Arcturus314/SSRController/ssrcontroller_basic/18 - MouserBom.xls

Mfr Part Number (Input) | Quantity 1 | Mfr Part Number | Mouser Part Number | Manufacturer Name | Description | Unit Price 1 | Order Quantity | Order Unit Price | Min./Mult. | Availability | Lead Time in Days | Lead Time in Weeks | Lifecycle | NCNR | RoHS | Pb Free | Package Type | Package Quantity | Datasheet URL | Product Image | Design Risk
713-102010268 | 1 | 102010268 | 713-102010268 | Seeed Studio | Development Boards & Kits - AVR Development Boards & Kits - AVR Seeeduino Nano | $8.62 | 1 | $8.62 | 1\1 | 114 | 97 | 14 | New Product | No | No | No |  | 1 |  |  | Product is new and is readily available.
80-ESK476M016AC3KA | 1 | ESK476M016AC3KA | 80-ESK476M016AC3KA | KEMET | Aluminum Electrolytic Capacitors - Radial Leaded Aluminum Electrolytic Capacitors - Radial Leaded 16V 47uF 85C 2k Hour Radial | $0.17 | 1 | $0.17 | 1\1 | 6,514 | 164 | 24 |  | No | Yes | Yes | REEL | 2,600 | https://www.mouser.com/datasheet/2/212/KEM_A4004_ESK-1103206.pdf |  | Product has high popularity and is readily available.
926-LM7805CT | 1 | LM7805CT/NOPB (https://www.mouser.com/ProductDetail/Texas-Instruments/LM7805CT-NOPB?qs=OYMYEaN9QmBS2GvaX6GSkQ%3D%3D) | 926-LM7805CT/NOPB | Texas Instruments | Linear Voltage Regulators 5 Volt Reg | $1.62 | 1 | $1.62
710-860010772003 | 1 | 860010772003 | 710-860010772003 | Wurth Elektronik | Aluminum Electrolytic Capacitors - Radial Leaded Aluminum Electrolytic Capacitors - Radial Leaded WCAP-ATG8 0.33uF 63V 20% Radial | $0.11 | 1 | $0.11 | 1\1 | 2,429 |  |  |  | No | Yes | Yes | AMMO PACK | 2,000 | https://www.mouser.com/datasheet/2/445/860010772003-1725323.pdf |  | Product has high popularity and is readily available.
710-860010772001 | 1 | 860010772001 | 710-860010772001 | Wurth Elektronik | Aluminum Electrolytic Capacitors - Radial Leaded Aluminum Electrolytic Capacitors - Radial Leaded WCAP-ATG8 0.1uF 63V 20% Radial | $0.10 | 1 | $0.10 | 1\1 | 1,272 | 155 | 23 |  | No | Yes | Yes | AMMO PACK | 2,000 | https://www.mouser.com/datasheet/2/445/860010772001-1725267.pdf |  | Product has high popularity and is readily available.
490-TB006-508-02BE | 5 | TB006-508-02BE | 490-TB006-508-02BE | CUI Devices | Fixed Terminal Blocks Fixed Terminal Blocks Terminal block, screw type, 5.08 , horizontal, 2 poles, CUI Blue, slotted screw, PCB mount | $0.55 | 5 | $0.55 | 1\1 | 5,122 | 65 | 10 | New at Mouser | No | Yes | Yes |  | 500 | https://www.mouser.com/datasheet/2/670/tb006_508-1550645.pdf |  | Product is new and is readily available.
163-4302-E | 1 | 163-4302-E | 163-4302-E | Kobiconn | DC Power Connectors DC Power Connectors PANEL MOUNT 2.1MM | $1.51 | 1 | $1.51 | 1\1 | 22,614 | 125 | 18 |  | No | Yes | Yes | BULK | 100 | https://www.mouser.com/datasheet/2/253/KC-301339-1177650.pdf |  | Product has high popularity and is readily available.
660-MFS1/4DCT52A1002 | 10 | MFS1/4DCT52A1002F | 660-MFS1/4DCT52A1002 | KOA Speer | Metal Film Resistors - Through Hole Metal Film Resistors - Through Hole 10K ohm 1% | $0.10 | 10 | $0.10 | 1\1 | 3,317 | 98 | 14 |  | No | Yes | Yes | AMMO PACK | 3,000 | https://www.mouser.com/datasheet/2/219/MF_MFS_RK-18760.pdf |  | Product has high popularity and is readily available.
858-P160KNP-3FD20B5K | 3 | P160KNP-3FD20B5K | 858-P160KNP-3FD20B5K | TT Electronics | Potentiometers Potentiometers 16mm 5K ohm 20% Rotary Potentiometer | $0.86 | 3 | $0.86 | 1\1 | 2,089 | 133 | 19 |  | No | Yes | No | TRAY | 1,100 | https://www.mouser.com/datasheet/2/414/P160-1545428.pdf |  | Product has high popularity and is readily available.
485-3429 | 3 | 3429 | 485-3429 | Adafruit | Adafruit Accessories Adafruit Accessories Mini LED Arcade Button - 24mm Translucent Clear | $2.50 | 3 | $2.50 | 1\1 | 30 | 114 | 17 |  | No | Yes | No |  | 1 |  |  | Product has high popularity and is readily available.
MF1/4LCT52R102G | 5 | MF1/4LCT52R102G | 660-MF1/4LCT52R102G | KOA Speer | Metal Film Resistors - Through Hole Metal Film Resistors - Through Hole 1/4 WATT 1K OHM 2% | $0.10 | 5 | $0.10 | 1\1 | 8,861 | 102 | 15 |  | No | Yes | Yes | REEL | 5,000 | https://www.mouser.com/datasheet/2/219/MF_MFS_RK-18760.pdf |  | Product has high popularity and is readily available.
612-PS1023ABLK | 2 | PS1023ABLK | 612-PS1023ABLK | E-Switch | Pushbutton Switches Pushbutton Switches 3A 125VAC Off-(On) Black | $1.51 | 2 | $1.51 | 1\1 | 724 | 112 | 16 |  | No | Yes | No |  | 1 | https://www.mouser.com/datasheet/2/140/E_Switch_PS1023-1165681.pdf |  | Product has high popularity and is readily available.
926-LM7805CT/NOPB | 1 | LM7805CT/NOPB | 926-LM7805CT/NOPB | Texas Instruments | Linear Voltage Regulators Linear Voltage Regulators 5 Volt Reg | $1.62 | 1 | $1.62 | 1\1 | 15,287 | 42 | 6 |  | No | Yes | No | TUBE | 45 | http://www.ti.com/general/docs/suppproductinfo.tsp?distId=26 |  | Product has high popularity and is readily available.
2N3904 PBFREE | 3 | 2N3904 PBFREE | 610-2N3904 | Central Semiconductor | Bipolar Transistors - BJT Bipolar Transistors - BJT NPN Gen Pur SS | $0.45 | 3 | $0.45 | 1\1 | 33,415 | 168 | 24 |  | No | Yes | Yes | BULK | 2,500 | https://my.centralsemi.com/datasheets/2N3903.PDF |  | Product has high popularity and is readily available.
R30-3011802 | 4 | R30-3011802 | 855-R30-3011802 | Harwin | Standoffs & Spacers M3 x 18mm HEX 5mmA/F 8mm ML/FML NICKEL | 0.64
