Arcturus314/SSRController/ssrcontroller/ssrcontroller_mcu/BOM.ods

Per-Board
Part | # | Price (single) | Price (total) | URL
Arduino Nano | 1 | 4 | 4 | https://www.amazon.com/ATmega328P-Controller-Module-CH340G-Arduino/dp/B07RQ8S1LG
47uF 12V cap | 1 | 0.06 | 0.06 | https://www.mouser.com/ProductDetail/Lelon/REA470M1CBK-0511P?qs=LVGG2qFPDbGuSPcHtpe6Lw%3D%3D
LM7805 (TO220) | 1 | 1.81 | 1.81 | https://www.mouser.com/ProductDetail/Texas-Instruments/LM7805CT?qs=QbsRYf82W3EaqXeMDVwIfQ%3D%3D
.33uF cap | 1 | 0.11 | 0.11 | https://www.mouser.com/ProductDetail/Wurth-Elektronik/860010772003
.1uF cap | 1 | 0.1 | 0.1 | https://www.mouser.com/ProductDetail/Wurth-Elektronik/860010772001
Power adapter | 1 | 7.99 | 7.99 | https://www.amazon.com/TMEZON-Power-Adapter-Supply-2-1mm/dp/B00Q2E5IXW?s=electronics
2.1x5.5 barrel jack | 1 | 1 | 1 | https://www.mouser.com/ProductDetail/Gravitech/CON-SOCJ-2155?qs=fkzBJ5HM%252BdCcpvFQyQZHtA%3D%3D
Pushbutton | 2 | 0.4 | 0.8 | https://www.mouser.com/ProductDetail/E-Switch/TL1105JAF250Q?qs=HKd%2Fp3M7KlXMyKdRvA%2FYOw%3D%3D
PCB | 1 | 0.7 | 0.7 | assuming quantity 15
Total |  |  | 16.57
Total for 555 implementation |  |  | 12
Per-Channel
Part | # | Price (single) | Price (total) | URL
Alps RK09K | 1 | 0.56 | 0.56 | https://www.mouser.com/ProductDetail/Alps-Alpine/RK09K1110-K25-C1-B103?qs=lhR5sLRcJHCQBwwGWQ%2F%252B5A%3D%3D
10K resistor | 2 | 0.005 | 0.01
3 pin header (2.54mm) | 1 | 0.1 | 0.1
5.08mm screw terminal | 1 | 0.55 | 0.55 | https://www.mouser.com/ProductDetail/CUI-Devices/TB006-508-02BE?qs=vLWxofP3U2wEdOVV%2FaT04w%3D%3D
2N3904 (TO92) | 1 | 0.45 | 0.45 | https://www.mouser.com/ProductDetail/Central-Semiconductor/2N3904-PBFREE?qs=u16ybLDytRZopNVvg2vJjA%3D%3D
Pushbutton | 1 | 0.4 | 0.4 | https://www.mouser.com/ProductDetail/E-Switch/TL1105JAF250Q?qs=HKd%2Fp3M7KlXMyKdRvA%2FYOw%3D%3D
SSR | 1 | 12 | 12
Total |  |  | 14.07
Total for 555 implementation |  |  | 16
Arduino |  | total | per channel
So for 12 channels, 1 channel per board |  | 367.68 | 30.64
So for 12 channels, 3 channels per board |  | 235.12 | 19.5933333333333
555 |  | total | per channel
So for 12 channels, 1 channel per board |  | 336 | 28
So for 12 channels, 3 channels per board |  | 240 | 20
New Stuff
Resistors for thermistor channels
Enclosure | https://www.amazon.com/Zulkit-Electronic-Enclosures-Enclosure-Preventive/dp/B08BS39P69
C14 panel mount connectors
barrel jack connector for panel power
Panel mount buttons and pots
Potentiometer knobs
Protection diodes for arduino vin
Can power Arduino with 12V anyway
