Arcturus314/SSRController/ssrcontroller/ssrcontroller_mcu/BOM_inbox.xlsx

Per-Board
Part | # | Price (single) | Price (total) | URL
Arduino Nano | 1 | 4 | 4 | https://www.amazon.com/ATmega328P-Controller-Module-CH340G-Arduino/dp/B07RQ8S1LG
47uF 12V cap | 1 | 0.06 | 0.06 | https://www.mouser.com/ProductDetail/Lelon/REA470M1CBK-0511P?qs=LVGG2qFPDbGuSPcHtpe6Lw%3D%3D
LM7805 (TO220) | 1 | 1.81 | 1.81 | https://www.mouser.com/ProductDetail/Texas-Instruments/LM7805CT?qs=QbsRYf82W3EaqXeMDVwIfQ%3D%3D
.33uF cap | 1 | 0.11 | 0.11 | https://www.mouser.com/ProductDetail/Wurth-Elektronik/860010772003
.1uF cap | 1 | 0.1 | 0.1 | https://www.mouser.com/ProductDetail/Wurth-Elektronik/860010772001
12V Power adapter | 1 | 7.99 | 7.99 | https://www.amazon.com/TMEZON-Power-Adapter-Supply-2-1mm/dp/B00Q2E5IXW?s=electronics
5.08mm screw terminal | 1 | 0.55 | 0.55 | https://www.mouser.com/ProductDetail/CUI-Devices/TB006-508-02BE?qs=vLWxofP3U2wEdOVV%2FaT04w%3D%3D
PCB | 1 | 0.7 | 0.7 | assuming quantity 15
Panel mount pushbutton | 2 | 1.51 | 1.7 | https://www.mouser.com/ProductDetail/E-Switch/PS1023ABLK?qs=QtyuwXswaQiGuKxM8UD2UA%3D%3D
Panel mount barrel jack | 1 | 1.51 | 2.7 | https://www.mouser.com/ProductDetail/Kobiconn/163-4302-E
Enclosure | 1 | 20.99 | 20.99 | https://www.amazon.com/Zulkit-Electronic-Enclosures-Enclosure-Preventive/dp/B08BS39P69
Total |  |  | 40.71
Per-Channel
Part | # | Price (single) | Price (total) | URL
10K resistor | 2 | 0.005 | 0.01
3 pin header (2.54mm) | 1 | 0.1 | 0.1
5.08mm screw terminal | 1 | 0.55 | 0.55 | https://www.mouser.com/ProductDetail/CUI-Devices/TB006-508-02BE?qs=vLWxofP3U2wEdOVV%2FaT04w%3D%3D
2N3904 (TO92) | 1 | 0.45 | 0.45 | https://www.mouser.com/ProductDetail/Central-Semiconductor/2N3904-PBFREE?qs=u16ybLDytRZopNVvg2vJjA%3D%3D
SSR | 1 | 12 | 12
Panel mount potentiometer | 1 | 0.86 | 0.86 | https://www.mouser.com/ProductDetail/BI-Technologies-TT-Electronics/P160KNP-3FD20B5K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
Panel mount pushbutton w/ LED | 1 | 2.5 | 2.5 | https://www.mouser.com/ProductDetail/Adafruit/3429/?qs=5aG0NVq1C4wproJuXLeckg%3D%3D
6mm knob | 1 | 4.33 | 4.33 | https://www.amazon.com/mxuteuk-Aluminum-Potentiometer-Electric-KNOB-06-25SR/dp/B07TSR4N4Q
Panel mount C14 connector | 1 | 0.699 | 0.699 | https://www.amazon.com/Panel-Adapter-Connector-Socket-MXR/dp/B07DCXKNXQ
Panel mount type A socket | 1 | 3.495 | 3.495 | https://www.amazon.com/AXLIZER-Outlet-Socket-Connector-Supply/dp/B08PTXCK5Q
Total |  |  | 24.994
Arduino |  | total | per channel
So for 12 channels, 1 channel per board |  | 788.448 | 65.704
So for 12 channels, 3 channels per board |  | 462.768 | 38.564
