Arcturus314/SSRController/ssrcontroller_basic/BoM_amazon_withoutspares.ods

Name | Quantity | Price | Extended Price | URL
Enclosure | 1 | 21.99 | 21.99 | https://www.amazon.com/Zulkit-Electronic-Enclosures-Enclosure-Preventive/dp/B08BS39P69
SSR | 3 | 12.29 | 36.87 | https://www.amazon.com/INKBIRD-Solid-State-SSR-40DA-24-380V/dp/B00HV974KC
Wall connectors | 2 | 6.99 | 13.98 | https://www.amazon.com/AXLIZER-Outlet-Socket-Connector-Supply/dp/B08PTXCK5Q
