Arcturus314/SSRController/ssrcontroller_basic/BoM_amazon.ods

Name | Quantity | Price | Extended Price | URL
12V Power Adapter | 1 | 13.88 | 13.88 | https://www.amazon.com/12V-Power-Supply-Driver-Transformer/dp/B08YDCL87G
Enclosure | 1 | 21.99 | 21.99 | https://www.amazon.com/Zulkit-Electronic-Enclosures-Enclosure-Preventive/dp/B08BS39P69
SSR | 2 | 12.29 | 24.58 | https://www.amazon.com/INKBIRD-Solid-State-SSR-40DA-24-380V/dp/B00HV974KC
Potentiometer Knobs | 1 | 9.99 | 9.99 | https://www.amazon.com/mxuteuk-Potentiometer-Control-Electric-KNOB-A03/dp/B07TTVPWTH
C14 connectors | 1 | 6.99 | 6.99 | https://www.amazon.com/Panel-Adapter-Connector-Socket-MXR/dp/B07DCXKNXQ
Wall connectors | 2 | 6.99 | 13.98 | https://www.amazon.com/AXLIZER-Outlet-Socket-Connector-Supply/dp/B08PTXCK5Q
