Arcturus314/SSRController/ssrcontroller/ssrcontroller_mcu/ssrcontroller_mcu.kicad_pcb

## KiCad design ssrcontroller/ssrcontroller_mcu/ssrcontroller_mcu.kicad_pcb (2021-08-17)

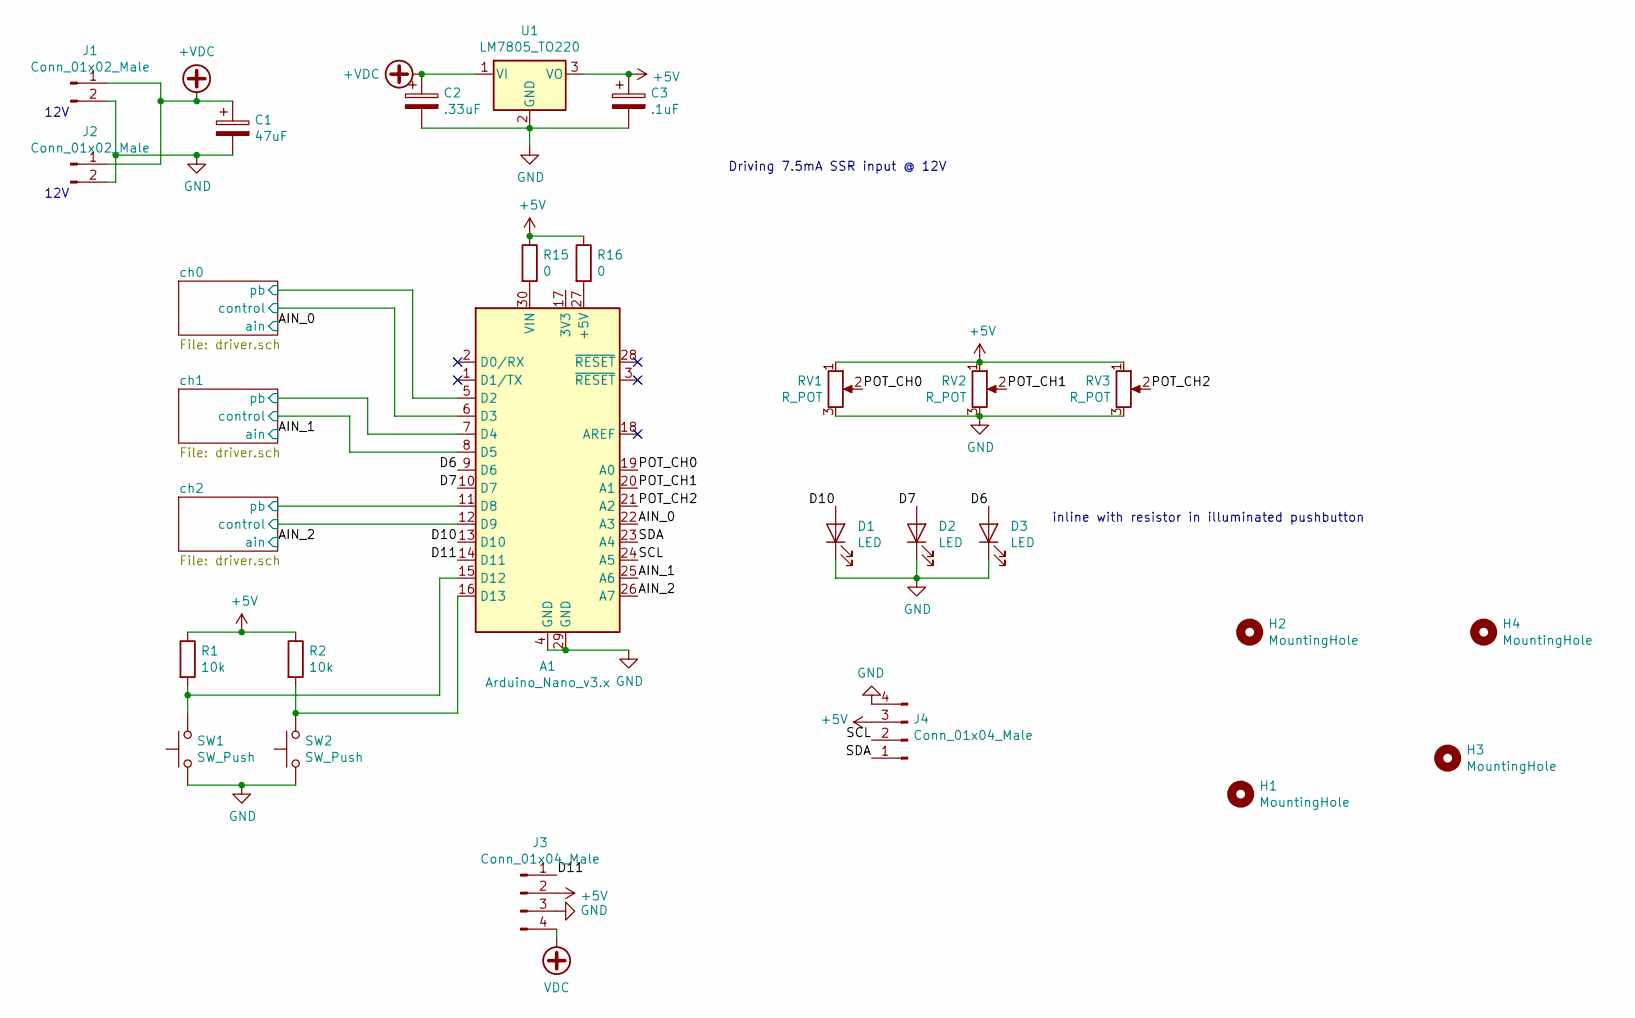
[picture p1: schematic ssrcontroller_mcu.sch]

Parts:
A1: Arduino_Nano_v3.x; Arduino_Nano
C1: 47uF; CP_Radial_D5.0mm_P2.00mm
C2: .33uF; CP_Radial_D5.0mm_P2.00mm
C3: .1uF; CP_Radial_D5.0mm_P2.00mm
D1, D2, D3: LED; PinHeader_1x02_P2.54mm_Vertical
H1, H2, H3, H4: MountingHole; MountingHole_3.2mm_M3_DIN965_Pad
J1: Conn_01x02_Male; BarrelJack_Horizontal
J2: Conn_01x02_Male; TerminalBlock_Phoenix_MKDS-1,5-2_1x02_P5.00mm_Horizontal
J3: Conn_01x04_Male; PinHeader_1x04_P2.54mm_Vertical
J4: Conn_01x04_Male; PinSocket_1x04_P2.54mm_Vertical
R1, R2: 10k; R_Axial_DIN0207_L6.3mm_D2.5mm_P7.62mm_Horizontal
R15, R16: 0; R_0603_1608Metric_Pad1.05x0.95mm_HandSolder
RV1, RV2, RV3: R_POT; Potentiometer_Alps_RK09K_Single_Horizontal
SW1, SW2: SW_Push; SW_Tactile_SKHH_Angled
U1: LM7805_TO220; TO-220-3_Horizontal_TabDown

Connections:
+5V: C3.1, J3.2, J4.3, R1.1, R2.1, R15.1, R16.1, RV1.1, RV2.1, RV3.1, U1.3 (VO); also elsewhere on the board
+VDC: C1.1, C2.1, J1.1, J2.1, U1.1 (VI); also elsewhere on the board
/AIN_0: A1.22 (A3); also elsewhere on the board
/AIN_1: A1.25 (A6); also elsewhere on the board
/AIN_2: A1.26 (A7); also elsewhere on the board
/D6: A1.9 (D6), D3.2 (A)
/D7: A1.10 (D7), D2.2 (A)
/D10: A1.13 (D10), D1.2 (A)
/D11: A1.14 (D11), J3.1
/POT_CH0: A1.19 (A0), RV1.2
/POT_CH1: A1.20 (A1), RV2.2
/POT_CH2: A1.21 (A2), RV3.2
/SCL: A1.24 (A5), J4.2
/SDA: A1.23 (A4), J4.1
/ch0/control: A1.6 (D3); also elsewhere on the board
/ch0/pb: A1.5 (D2); also elsewhere on the board
/ch1/control: A1.8 (D5); also elsewhere on the board
/ch1/pb: A1.7 (D4); also elsewhere on the board
/ch2/control: A1.12 (D9); also elsewhere on the board
/ch2/pb: A1.11 (D8); also elsewhere on the board
GND: A1.4 (GND), A1.29 (GND), C1.2, C2.2, C3.2, D1.1 (K), D2.1 (K), D3.1 (K), J1.2, J2.2, J3.3, J4.4, RV1.3, RV2.3, RV3.3, SW1.1, SW2.1, U1.2 (GND); also elsewhere on the board
unnamed: A1.15 (D12), R1.2, SW1.2
unnamed: A1.16 (D13), R2.2, SW2.2
unnamed: A1.27 (+5V), R16.2
unnamed: A1.30 (VIN), R15.2
VDC: J3.4

Notes on the sheet:
Driving 7.5mA SSR input @ 12V
12V
inline with resistor in illuminated pushbutton

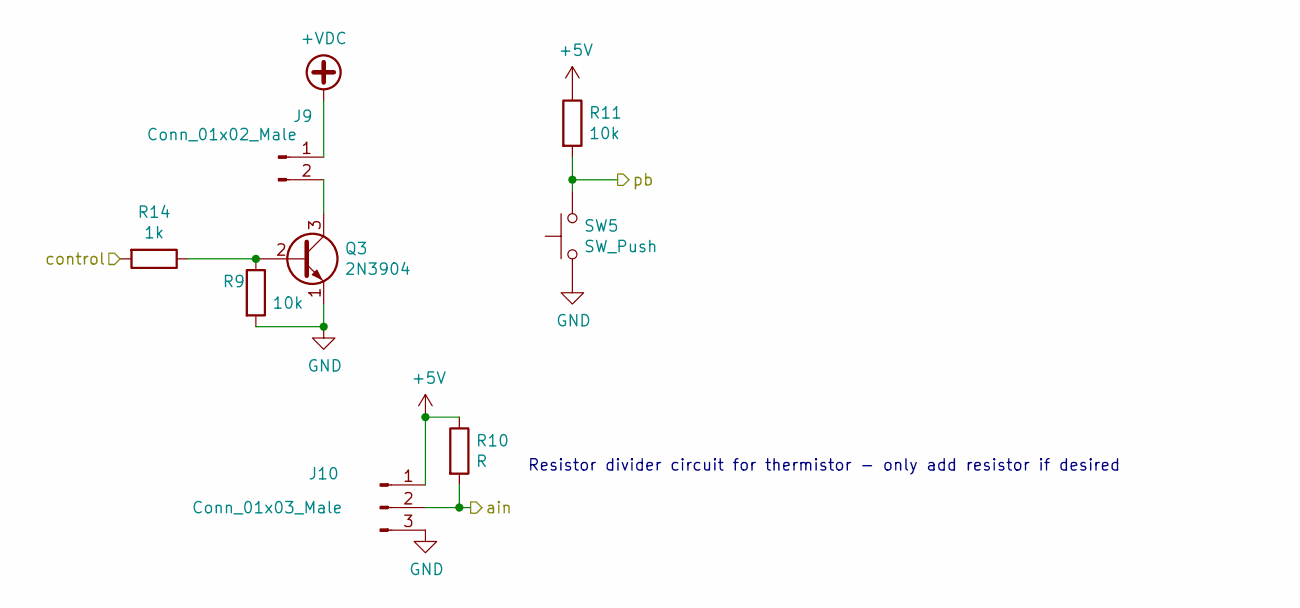
[picture p2: schematic driver.sch]

Parts:
J5: Conn_01x02_Male; TerminalBlock_Phoenix_MKDS-1,5-2_1x02_P5.00mm_Horizontal
J6: Conn_01x03_Male; PinHeader_1x03_P2.54mm_Vertical
Q1: 2N3904; TO-92_Inline
R3, R5: 10k; R_Axial_DIN0207_L6.3mm_D2.5mm_P7.62mm_Horizontal
R4: R; R_Axial_DIN0207_L6.3mm_D2.5mm_P7.62mm_Horizontal
R12: 1k; R_Axial_DIN0207_L6.3mm_D2.5mm_P7.62mm_Horizontal
SW3: SW_Push; SW_Tactile_SKHH_Angled

Connections:
+5V: J6.1, R4.1, R5.1; also elsewhere on the board
+VDC: J5.1; also elsewhere on the board
/AIN_0: J6.2, R4.2; also elsewhere on the board
/ch0/control: R12.2; also elsewhere on the board
/ch0/pb: R5.2, SW3.2; also elsewhere on the board
GND: J6.3, Q1.1 (E), R3.2, SW3.1; also elsewhere on the board
unnamed: J5.2, Q1.3 (C)
unnamed: Q1.2 (B), R3.1, R12.1

Parts of its further copies:
J7, J9: Conn_01x02_Male; TerminalBlock_Phoenix_MKDS-1,5-2_1x02_P5.00mm_Horizontal
J8, J10: Conn_01x03_Male; PinHeader_1x03_P2.54mm_Vertical
Q2, Q3: 2N3904; TO-92_Inline
R6, R8, R9, R11: 10k; R_Axial_DIN0207_L6.3mm_D2.5mm_P7.62mm_Horizontal
R7, R10: R; R_Axial_DIN0207_L6.3mm_D2.5mm_P7.62mm_Horizontal
R13, R14: 1k; R_Axial_DIN0207_L6.3mm_D2.5mm_P7.62mm_Horizontal
SW4, SW5: SW_Push; SW_Tactile_SKHH_Angled

Connections of its further copies:
+5V: J8.1, J10.1, R7.1, R8.1, R10.1, R11.1; also elsewhere on the board
+VDC: J7.1, J9.1; also elsewhere on the board
/AIN_1: J8.2, R7.2; also elsewhere on the board
/AIN_2: J10.2, R10.2; also elsewhere on the board
/ch1/control: R13.2; also elsewhere on the board
/ch1/pb: R8.2, SW4.2; also elsewhere on the board
/ch2/control: R14.2; also elsewhere on the board
/ch2/pb: R11.2, SW5.2; also elsewhere on the board
GND: J8.3, J10.3, Q2.1 (E), Q3.1 (E), R6.2, R9.2, SW4.1, SW5.1; also elsewhere on the board
unnamed: J7.2, Q2.3 (C)
unnamed: J9.2, Q3.3 (C)
unnamed: Q2.2 (B), R6.1, R13.1
unnamed: Q3.2 (B), R9.1, R14.1

Notes on the sheet:
Resistor divider circuit for thermistor - only add resistor if desired

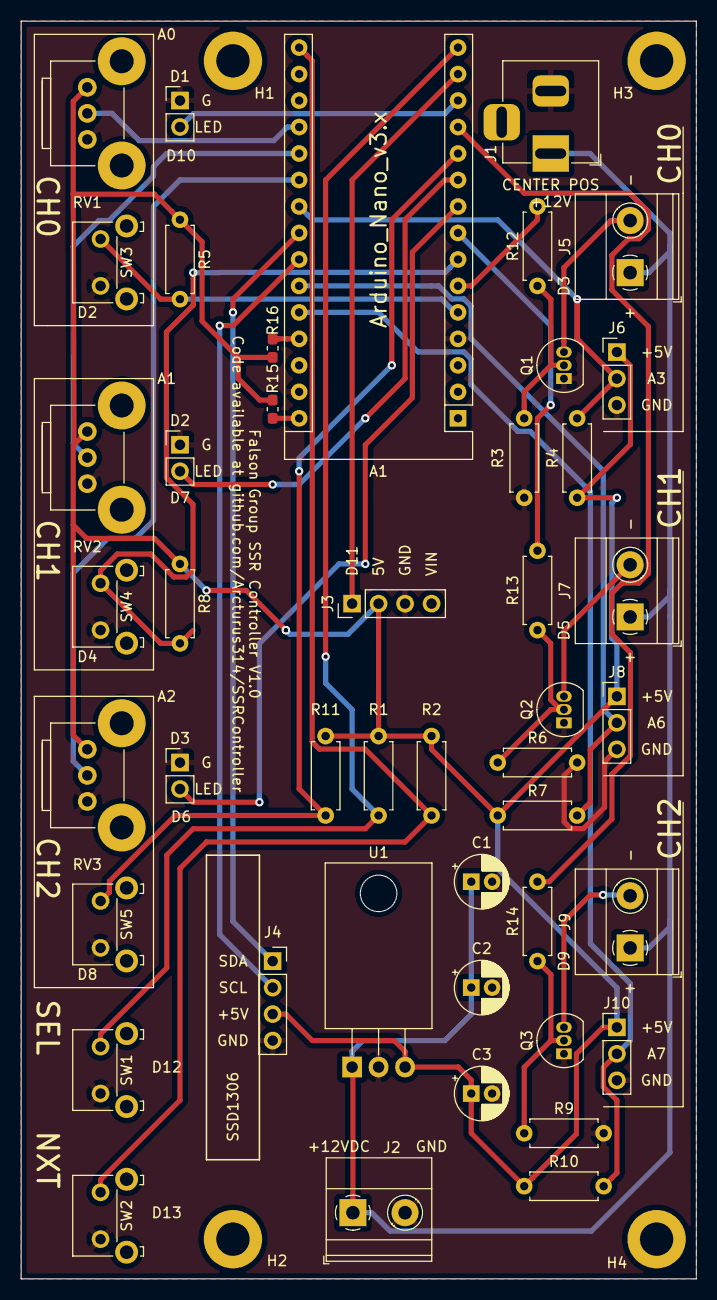
[picture p3: board ssrcontroller_mcu.kicad_pcb from above]

Board: 2 copper layers, 64.8 x 120.7 mm, 49 parts (0 on the bottom side), 31 nets.
