Arcturus314/SSRController/(commit log)

2021-03-31 added BoMs
    [18 - MouserBom.xls, BoM_amazon.ods]
2021-04-02 updated BoM
    [BoM_amazon.ods]
2021-04-02 updated Mouser BoM
    [18 - MouserBom.xls]
2021-04-17 added Amazon BoM without spares
    [BoM_amazon_withoutspares.ods]
2021-04-24 Added standoffs to BoM
    [18 - MouserBom.xls]
2021-08-17 added pcb files
    [BOM.ods, BOM_inbox.ods, BOM_inbox.xlsx, driver.sch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]
